M-S-Ali/raven-i-sentinel/electronics/PCB_BQ76925_ATMEGA328P_6S_20A_BMS/pcb_assets/BQ76925_ATMEGA328P_6S_20A_BMS.jpg

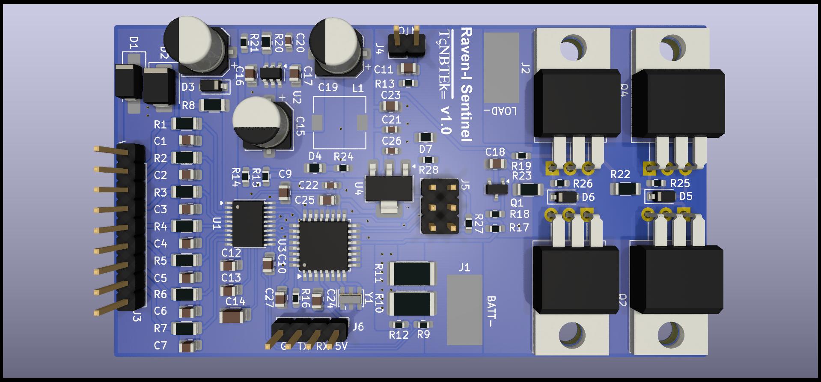
electronics/PCB_BQ76925_ATMEGA328P_6S_20A_BMS/pcb_assets/BQ76925_ATMEGA328P_6S_20A_BMS.jpg
