M-S-Ali/raven-i-sentinel/README.md

# Raven I Sentinel

  
