M-S-Ali/raven-i-sentinel/docs/datasheets.md

# Datasheets

This document provides links to official datasheets and manuals for the major components used in this project.

---

## Microcontroller
- **ATmega328P**  
  [ATmega328 Datasheet (Microchip)](https://www.microchip.com/en-us/product/atmega328p)
---

## Analog Front End IC
- **BQ76925 AFE**  
  [BQ76925 Datasheet (Texas Instruments)](https://www.ti.com/lit/ds/symlink/bq76925.pdf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)    
  [BQ76925 Getting Started Application Report](https://www.ti.com/lit/an/slua619b/slua619b.pdf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)
---

## Voltage Regulators
- **LMR50410**   
  [LMR50410 Simple Switcher Datasheet(Texas Instruments)](https://www.ti.com/lit/ds/symlink/lmr50410.pdf)   

- **AMS1117-5.0**   
  [AMS1117-5.0 Low Dropout Regulator Datasheet (Advanced Monolithic Systems)](http://www.advanced-monolithic.com/pdf/ds1117.pdf)
---

## MOSFET
- **IRFB4110**
  [IRFB4110 Power MOSFET Datasheet (Infineon)](https://www.infineon.com/dgdl/irfb4110pbf.pdf?fileId=5546d462533600a401535615a9571e0b)
---

## Shunt Resistor   
- **WSTM2512DLR002FYR (2mOhm Resistor)**    
  [2mOhm Chip Resistor Datasheet (Littlefuse)](https://mm.digikey.com/Volume0/opasdata/d220001/medias/docus/4897/WSTM_Series_3-17-23.pdf)
---

## Transistor    
- **BC817**    
  [BC817 NPN Datasheet (Diodes Incorporated)](https://www.diodes.com/assets/Datasheets/ds11107.pdf)
---
