M-S-Ali/raven-i-sentinel/electronics/PCB_BQ76925_ATMEGA328P_6S_20A_BMS/pcb_library/3d_models/C_0603_1608Metric.step

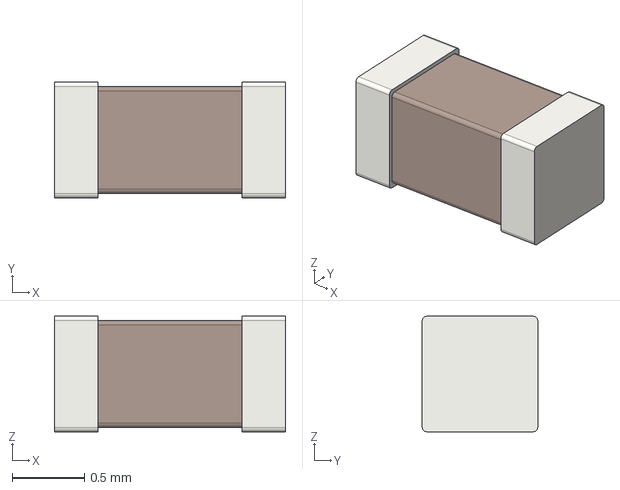
[picture p3: CAD file, 2024-12-04]
electronics/PCB_BQ76925_ATMEGA328P_6S_20A_BMS/pcb_library/3d_models/C_0603_1608Metric.step
1.60 x 0.8 x 0.8 mm
