M-S-Ali/raven-i-sentinel/electronics/PCB_BQ76925_ATMEGA328P_6S_20A_BMS/pcb_library/3d_models/Resonator_SMD_Murata_CSTxExxV-3Pin_3.0x1.1mm.step

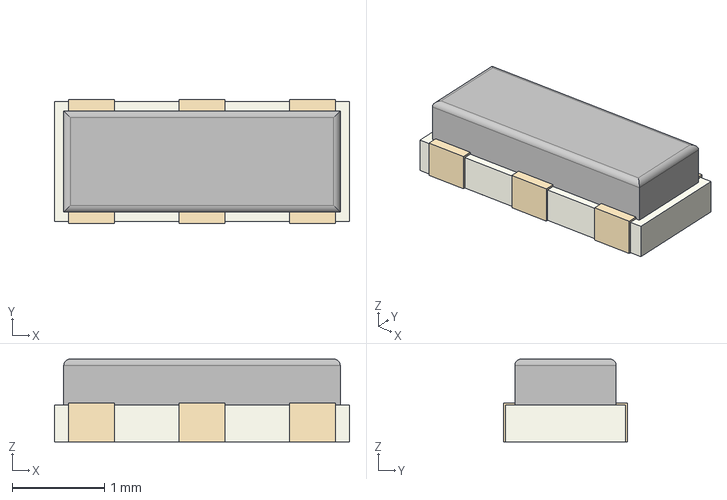
[picture p4: CAD file, 2024-12-04]
electronics/PCB_BQ76925_ATMEGA328P_6S_20A_BMS/pcb_library/3d_models/Resonator_SMD_Murata_CSTxExxV-3Pin_3.0x1.1mm.step
3.20 x 1.35 x 0.9 mm
