M-S-Ali/raven-i-sentinel/electronics/PCB_BQ76925_ATMEGA328P_6S_20A_BMS/pcb_library/3d_models/D_SOD-123.step

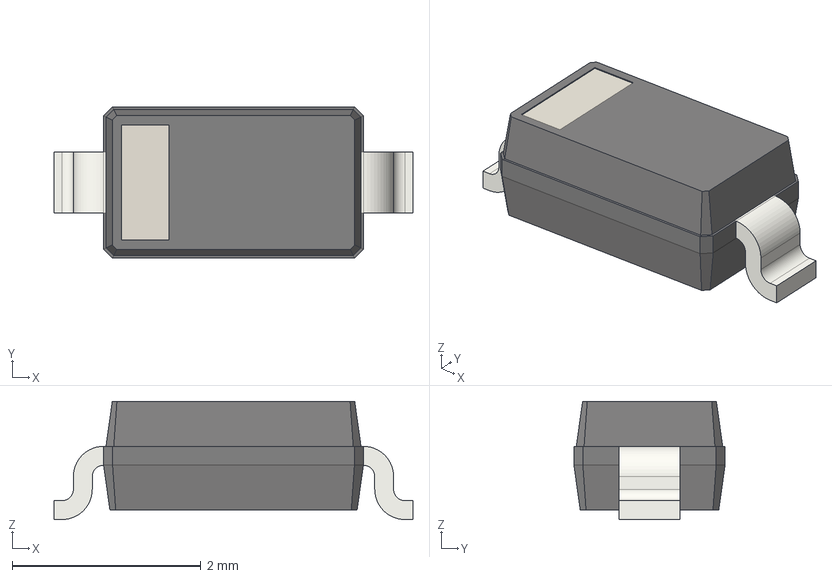
[picture p5: CAD file, 2024-12-04]
electronics/PCB_BQ76925_ATMEGA328P_6S_20A_BMS/pcb_library/3d_models/D_SOD-123.step
3.80 x 1.60 x 1.25 mm
