M-S-Ali/raven-i-sentinel/electronics/PCB_BQ76925_ATMEGA328P_6S_20A_BMS/pcb_library/3d_models/D_SMB.step

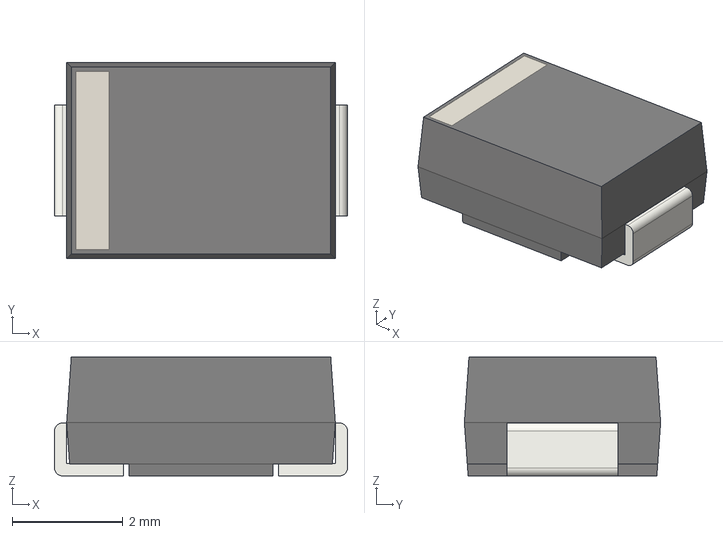
[picture p6: CAD file, 2024-12-04]
electronics/PCB_BQ76925_ATMEGA328P_6S_20A_BMS/pcb_library/3d_models/D_SMB.step
5.30 x 3.55 x 2.15 mm
