M-S-Ali/raven-i-sentinel/electronics/PCB_BQ76925_ATMEGA328P_6S_20A_BMS/pcb_library/3d_models/TSSOP-20_4.4x6.5mm_P0.65mm.step

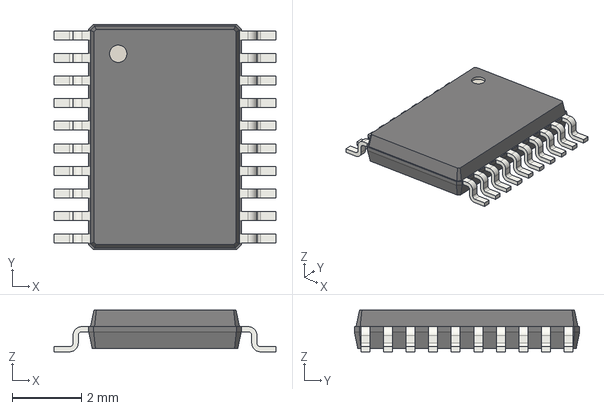
[picture p15: CAD file, 2024-12-04]
electronics/PCB_BQ76925_ATMEGA328P_6S_20A_BMS/pcb_library/3d_models/TSSOP-20_4.4x6.5mm_P0.65mm.step
6.40 x 6.50 x 1.20 mm
