M-S-Ali/raven-i-sentinel/electronics/PCB_BQ76925_ATMEGA328P_6S_20A_BMS/pcb_library/3d_models/TQFP-32_7x7mm_P0.8mm.step

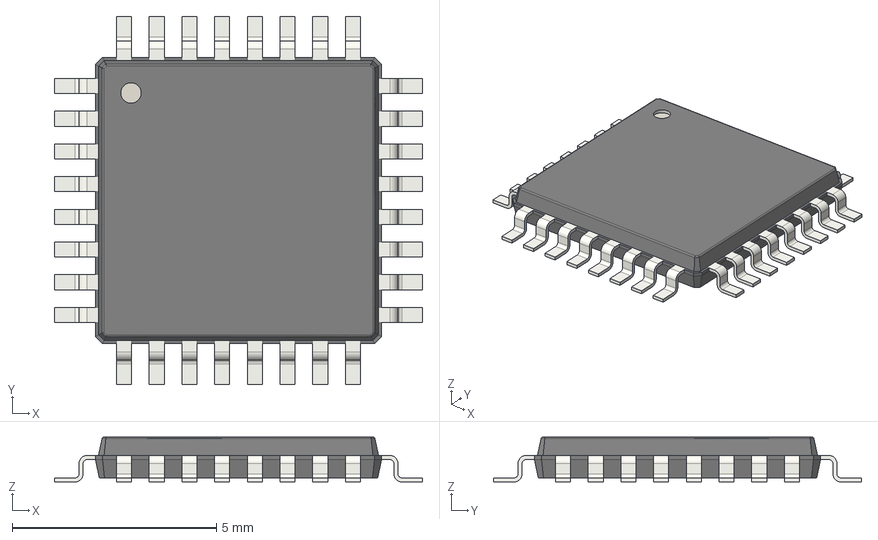
[picture p19: CAD file, 2024-12-04]
electronics/PCB_BQ76925_ATMEGA328P_6S_20A_BMS/pcb_library/3d_models/TQFP-32_7x7mm_P0.8mm.step
9.00 x 9.00 x 1.10 mm
