M-S-Ali/raven-i-sentinel/electronics/PCB_BQ76925_ATMEGA328P_6S_20A_BMS/pcb_library/3d_models/CP_Elec_6.3x5.7.step

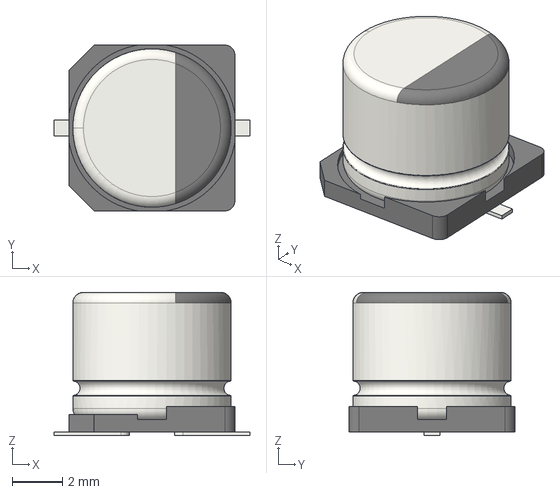
[picture p20: CAD file, 2024-12-04]
electronics/PCB_BQ76925_ATMEGA328P_6S_20A_BMS/pcb_library/3d_models/CP_Elec_6.3x5.7.step
7.80 x 6.60 x 5.70 mm
