M-S-Ali/raven-i-sentinel/electronics/PCB_BQ76925_ATMEGA328P_6S_20A_BMS/pcb_library/3d_models/TO-220-3_Horizontal_TabDown.step

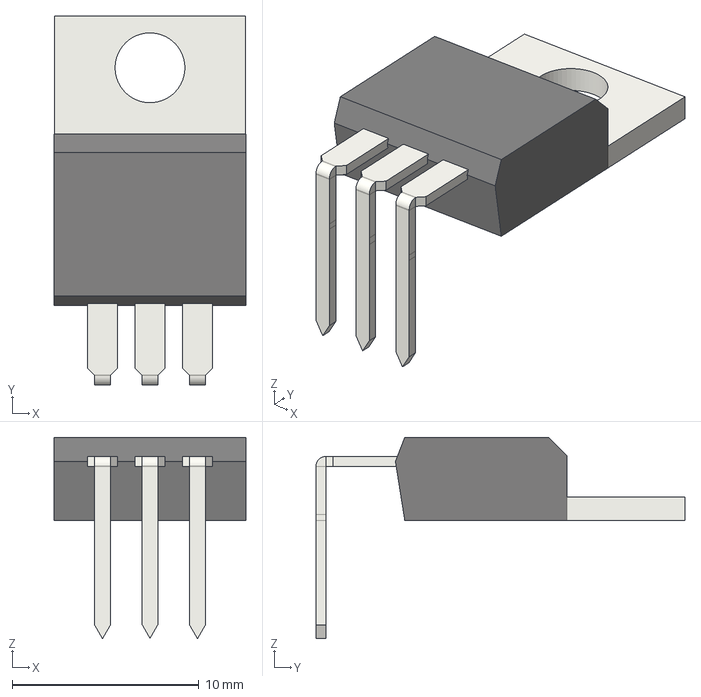
[picture p22: CAD file, 2024-12-04]
electronics/PCB_BQ76925_ATMEGA328P_6S_20A_BMS/pcb_library/3d_models/TO-220-3_Horizontal_TabDown.step
10.2 x 19.7 x 10.8 mm
