M-S-Ali/raven-i-sentinel/electronics/PCB_BQ76925_ATMEGA328P_6S_20A_BMS/pcb_library/3d_models/PinHeader_2x03_P2.54mm_Vertical.step

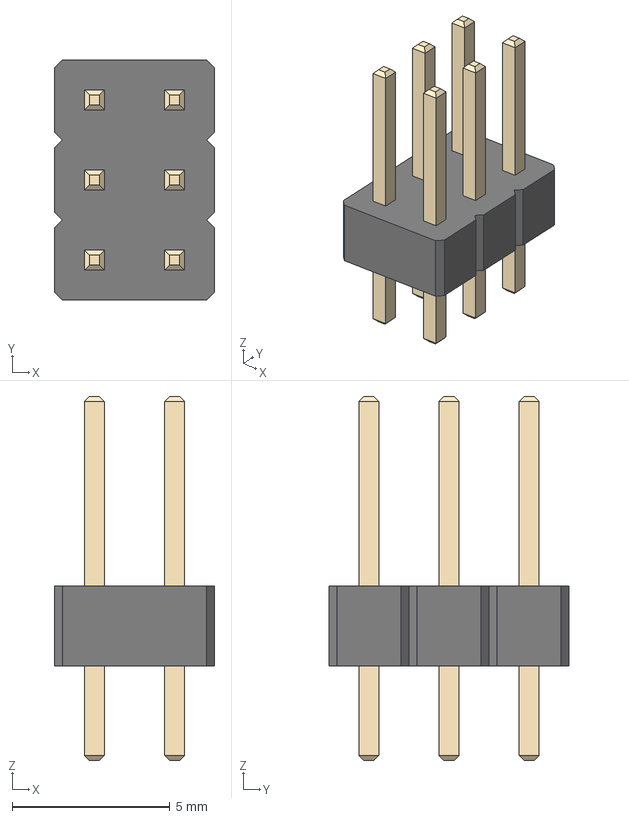
[picture p23: CAD file, 2024-12-04]
electronics/PCB_BQ76925_ATMEGA328P_6S_20A_BMS/pcb_library/3d_models/PinHeader_2x03_P2.54mm_Vertical.step
5.08 x 7.62 x 11.5 mm
