M-S-Ali/raven-i-sentinel/electronics/PCB_BQ76925_ATMEGA328P_6S_20A_BMS/pcb_assets/BQ76925_ATMEGA328P_6S_20A_BMS.pdf

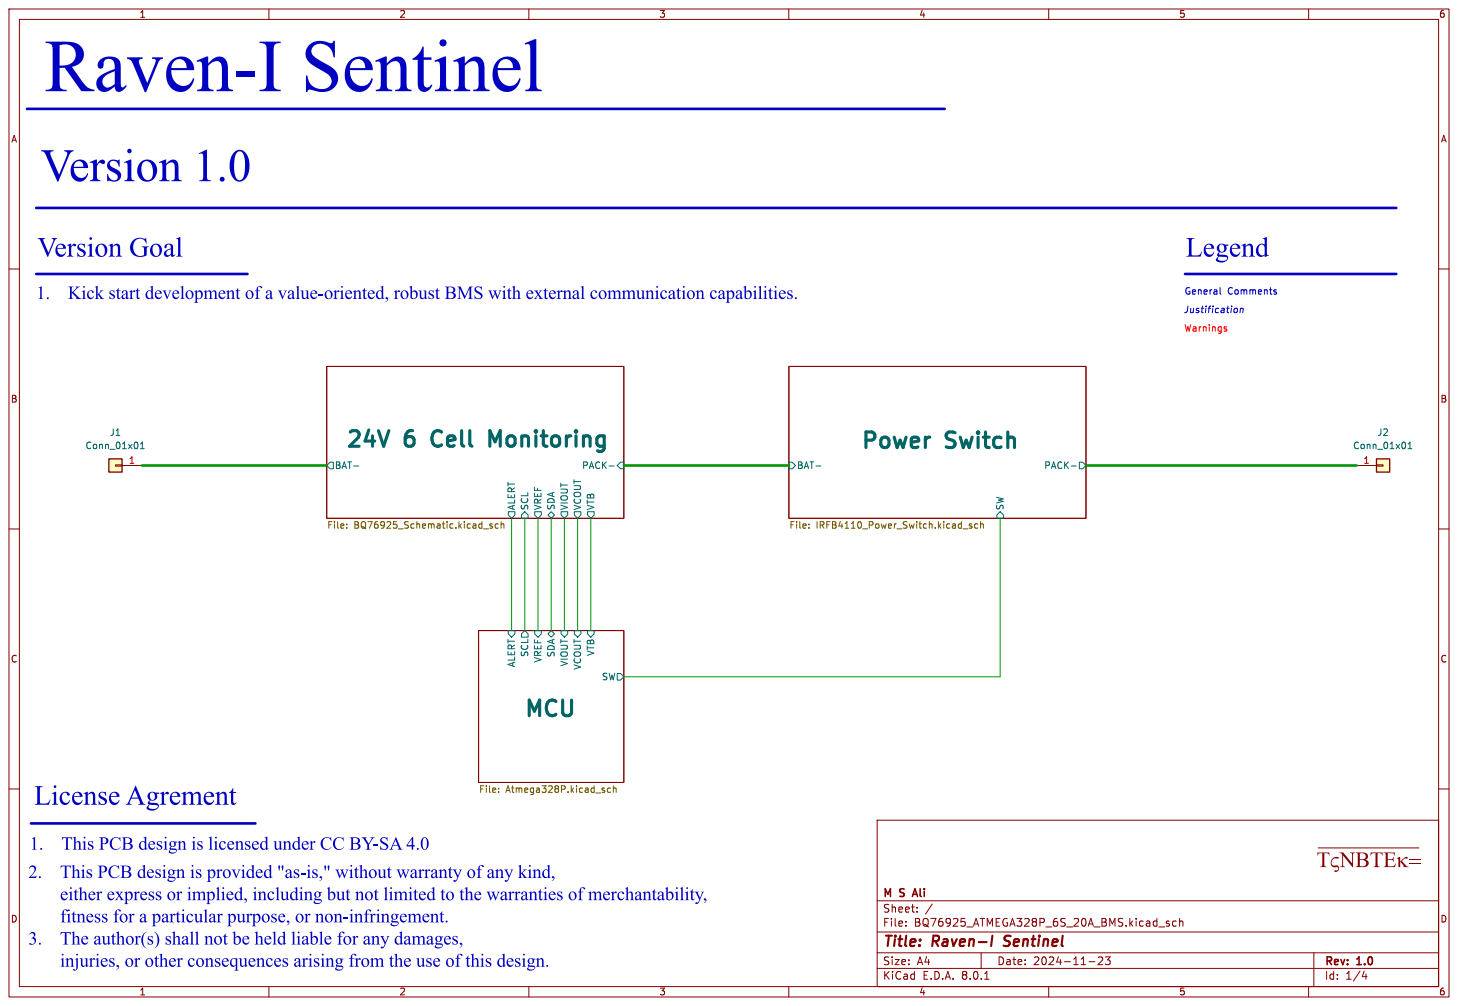
[picture p25: page 1]

J2 Conn_01x01 1. Kick startdevelopmentof a value-oriented,robustBMS with externalcommunicationcapabilities.
Warnings General Comments 1. This PCBdesignis licensedunderCC BY-SA4.0

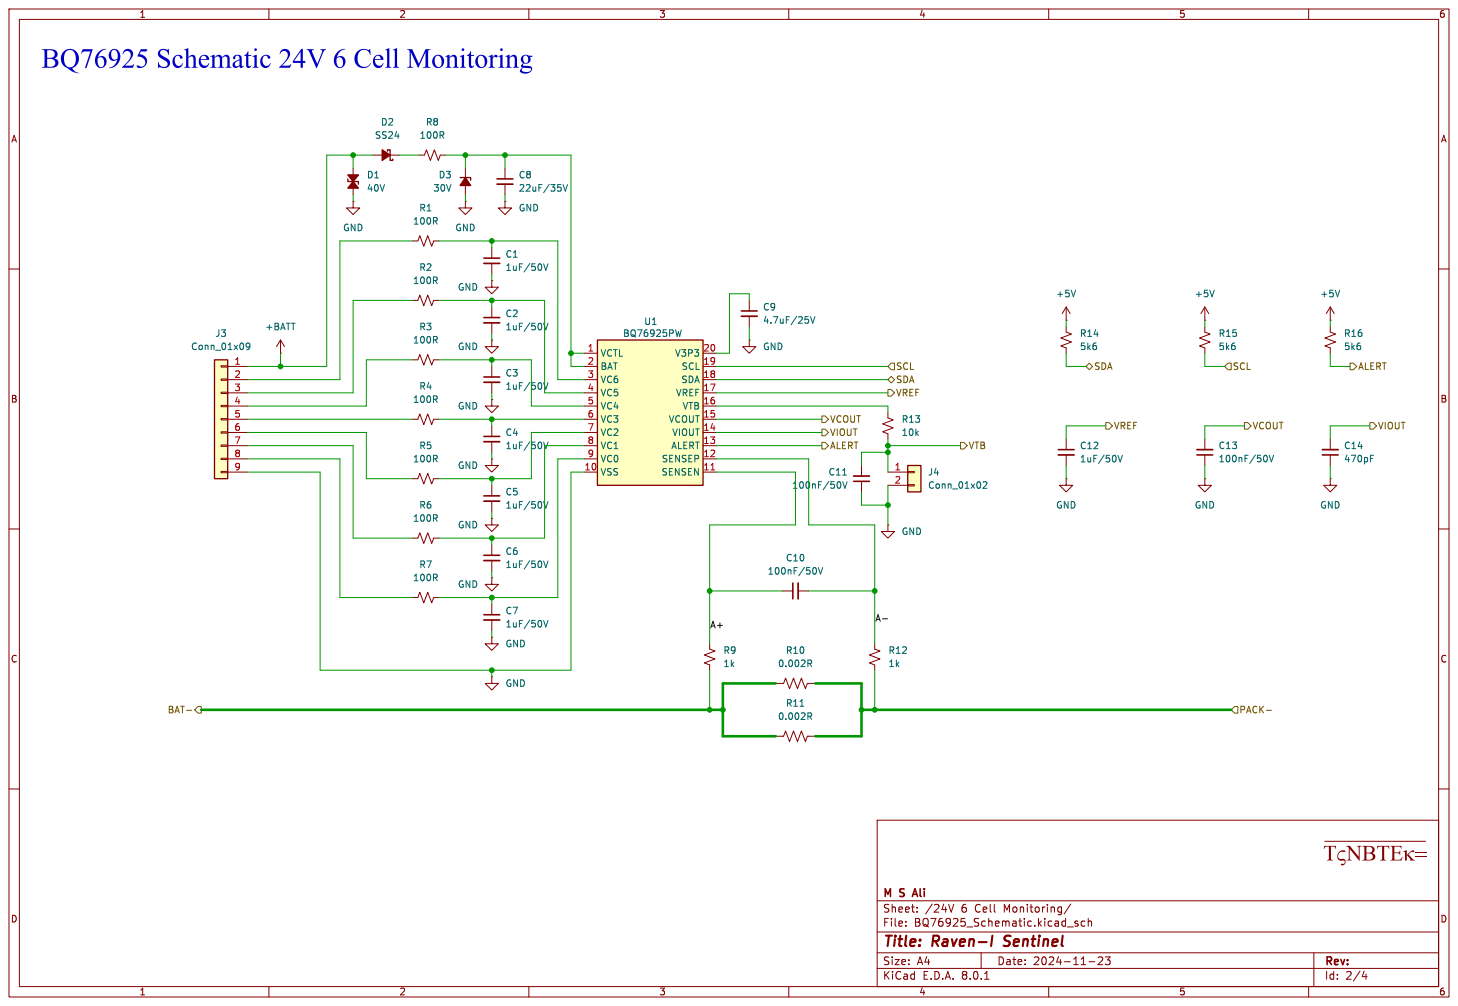
[picture p26: page 2]

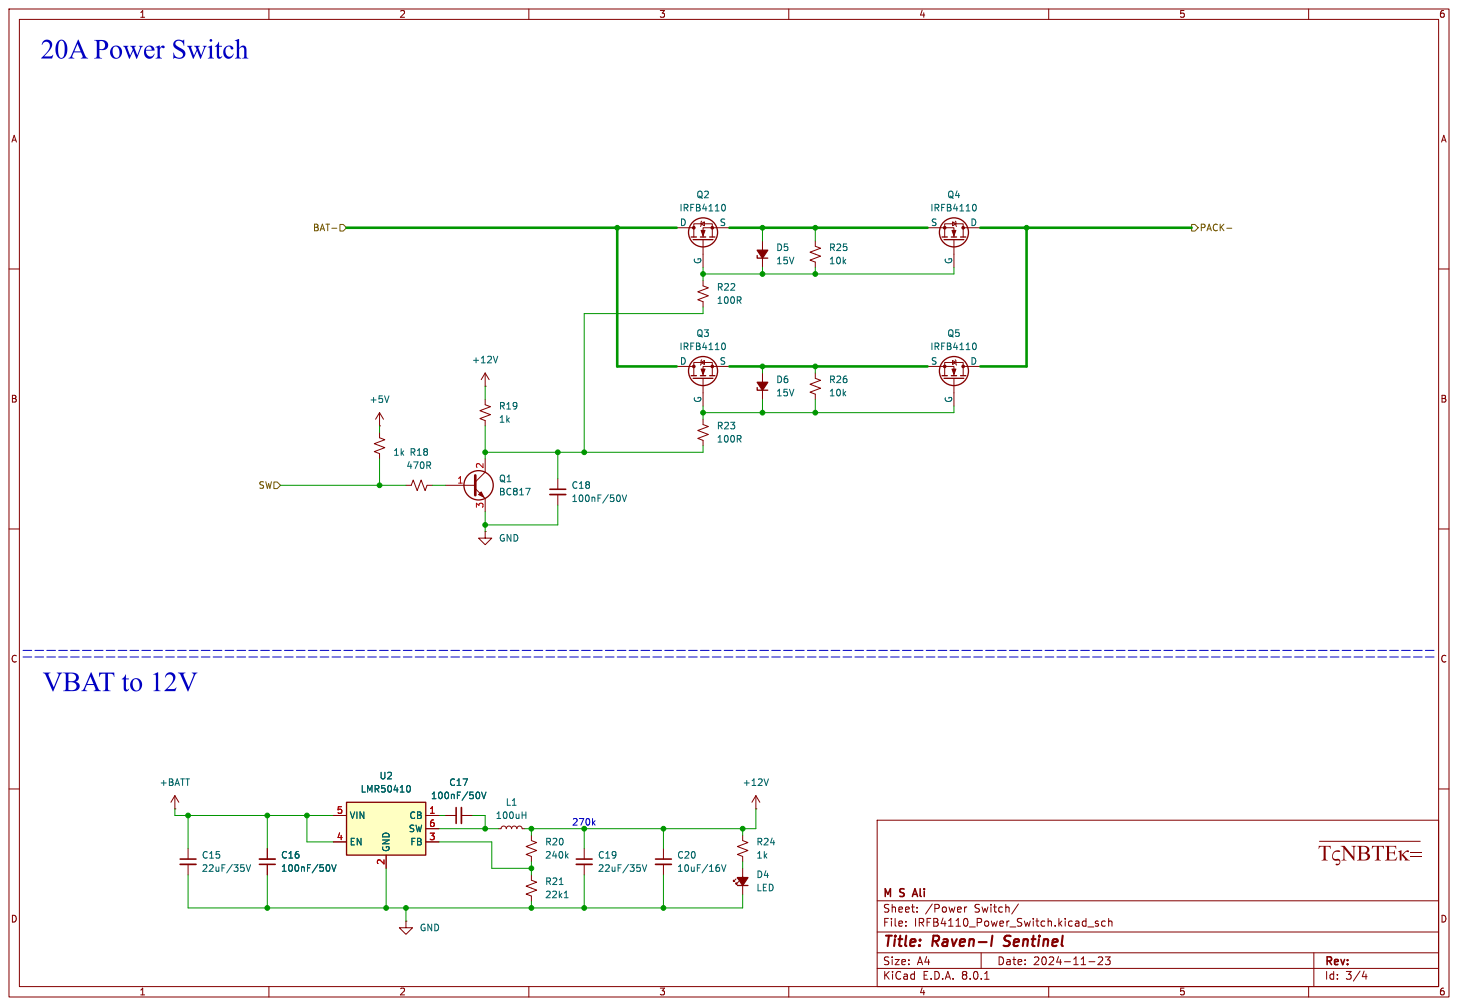
[picture p27: page 3]

2 FB 3 EN 4 VIN 5 SW 6 U2

2 FB 3 EN 4 VIN 5 SW 6 C16

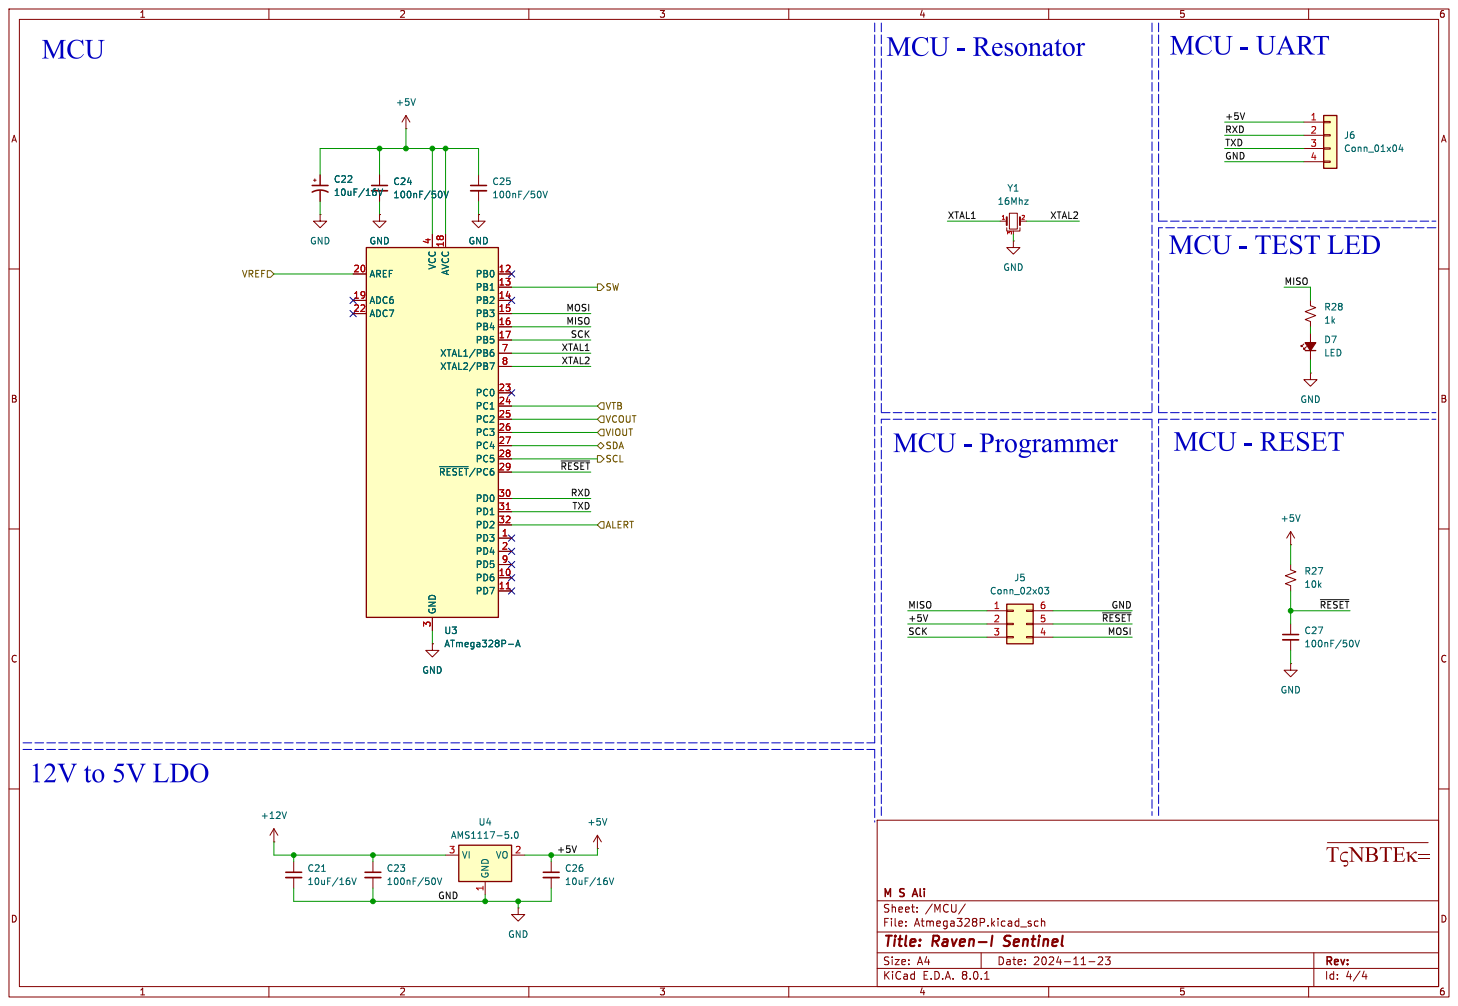
[picture p28: page 4]

~{RESET} +5V MISO MOSI MISO
