M-S-Ali/raven-i-sentinel/electronics/PCB_BQ76925_ATMEGA328P_6S_20A_BMS/BQ76925_ATMEGA328P_6S_20A_BMS.kicad_pcb

## KiCad design electronics/PCB_BQ76925_ATMEGA328P_6S_20A_BMS/BQ76925_ATMEGA328P_6S_20A_BMS.kicad_pcb (2024-12-04)

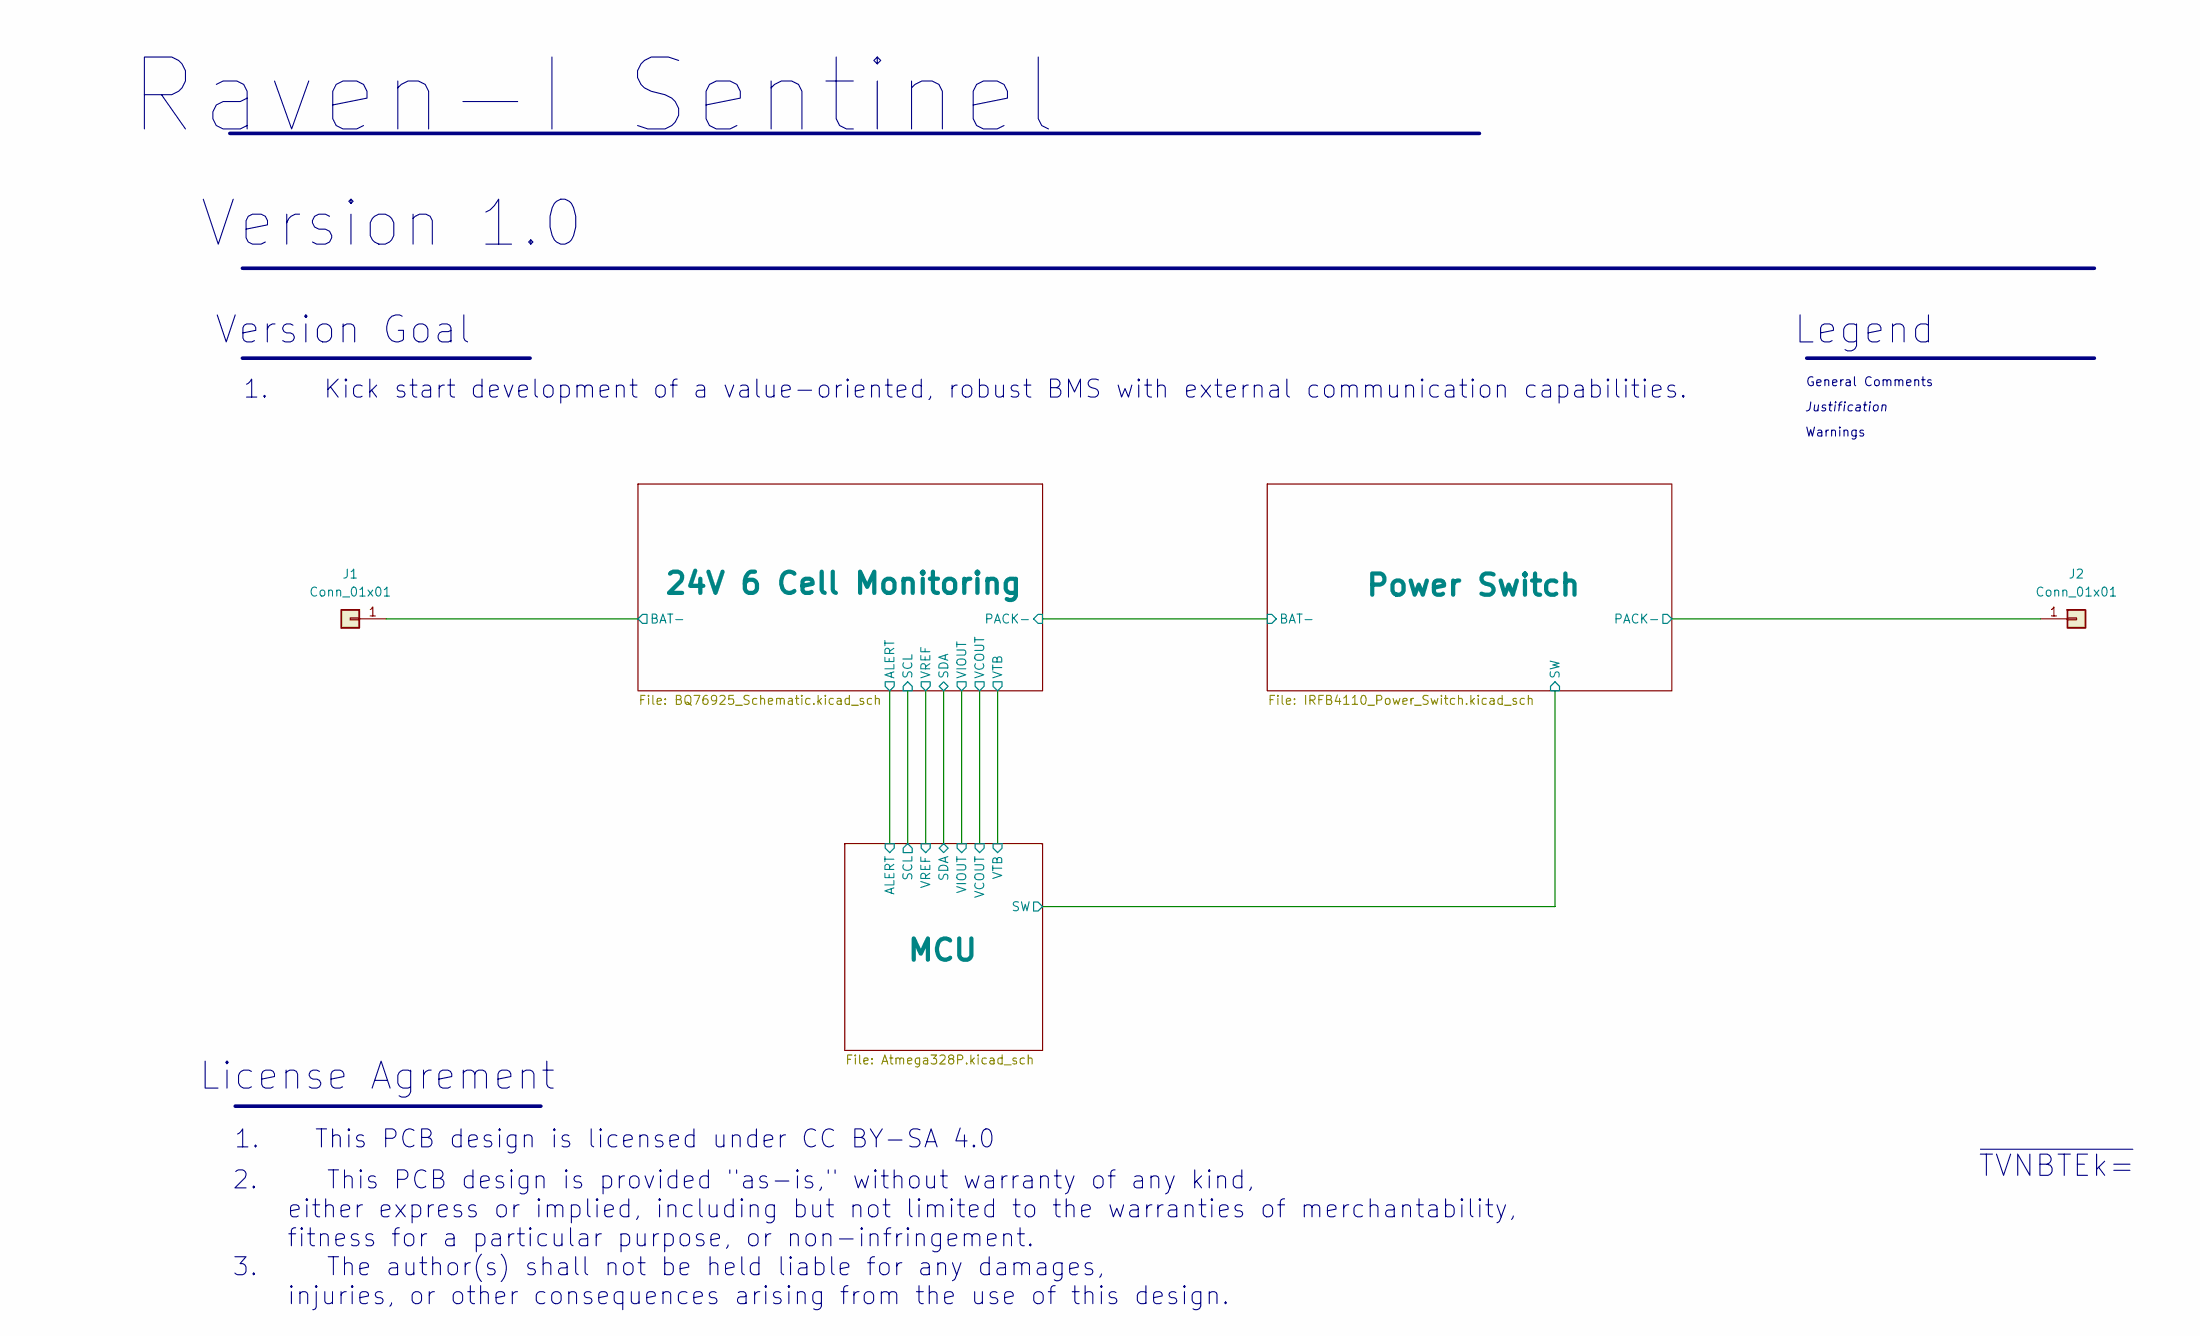
[picture p29: schematic BQ76925_ATMEGA328P_6S_20A_BMS.kicad_sch, Raven-I Sentinel]

Parts:
J1, J2: Conn_01x01; SolderWirePad_1x01_SMD_5x10mm

Connections:
/24V 6 Cell Monitoring/BAT-: J1.1; also elsewhere on the board
/Power Switch/PACK-: J2.1; also elsewhere on the board

Notes on the sheet:
1. This PCB design is licensed under CC BY-SA 4.0
Justification
1. Kick start development of a value-oriented, robust BMS with external communication capabilities.
~{TVNBTEk=}
License Agrement
Warnings
2. This PCB design is provided "as-is," without warranty of any kind, either express or implied, including but not limited to the warranties of merchantability, fitness for a particular purpose, or non-infringement. 3. The author(s) shall not be held liable for any damages, injuries, or other conse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
General Comments
Version ${REVISION}
Raven-I Sentinel
Version Goal
Legend

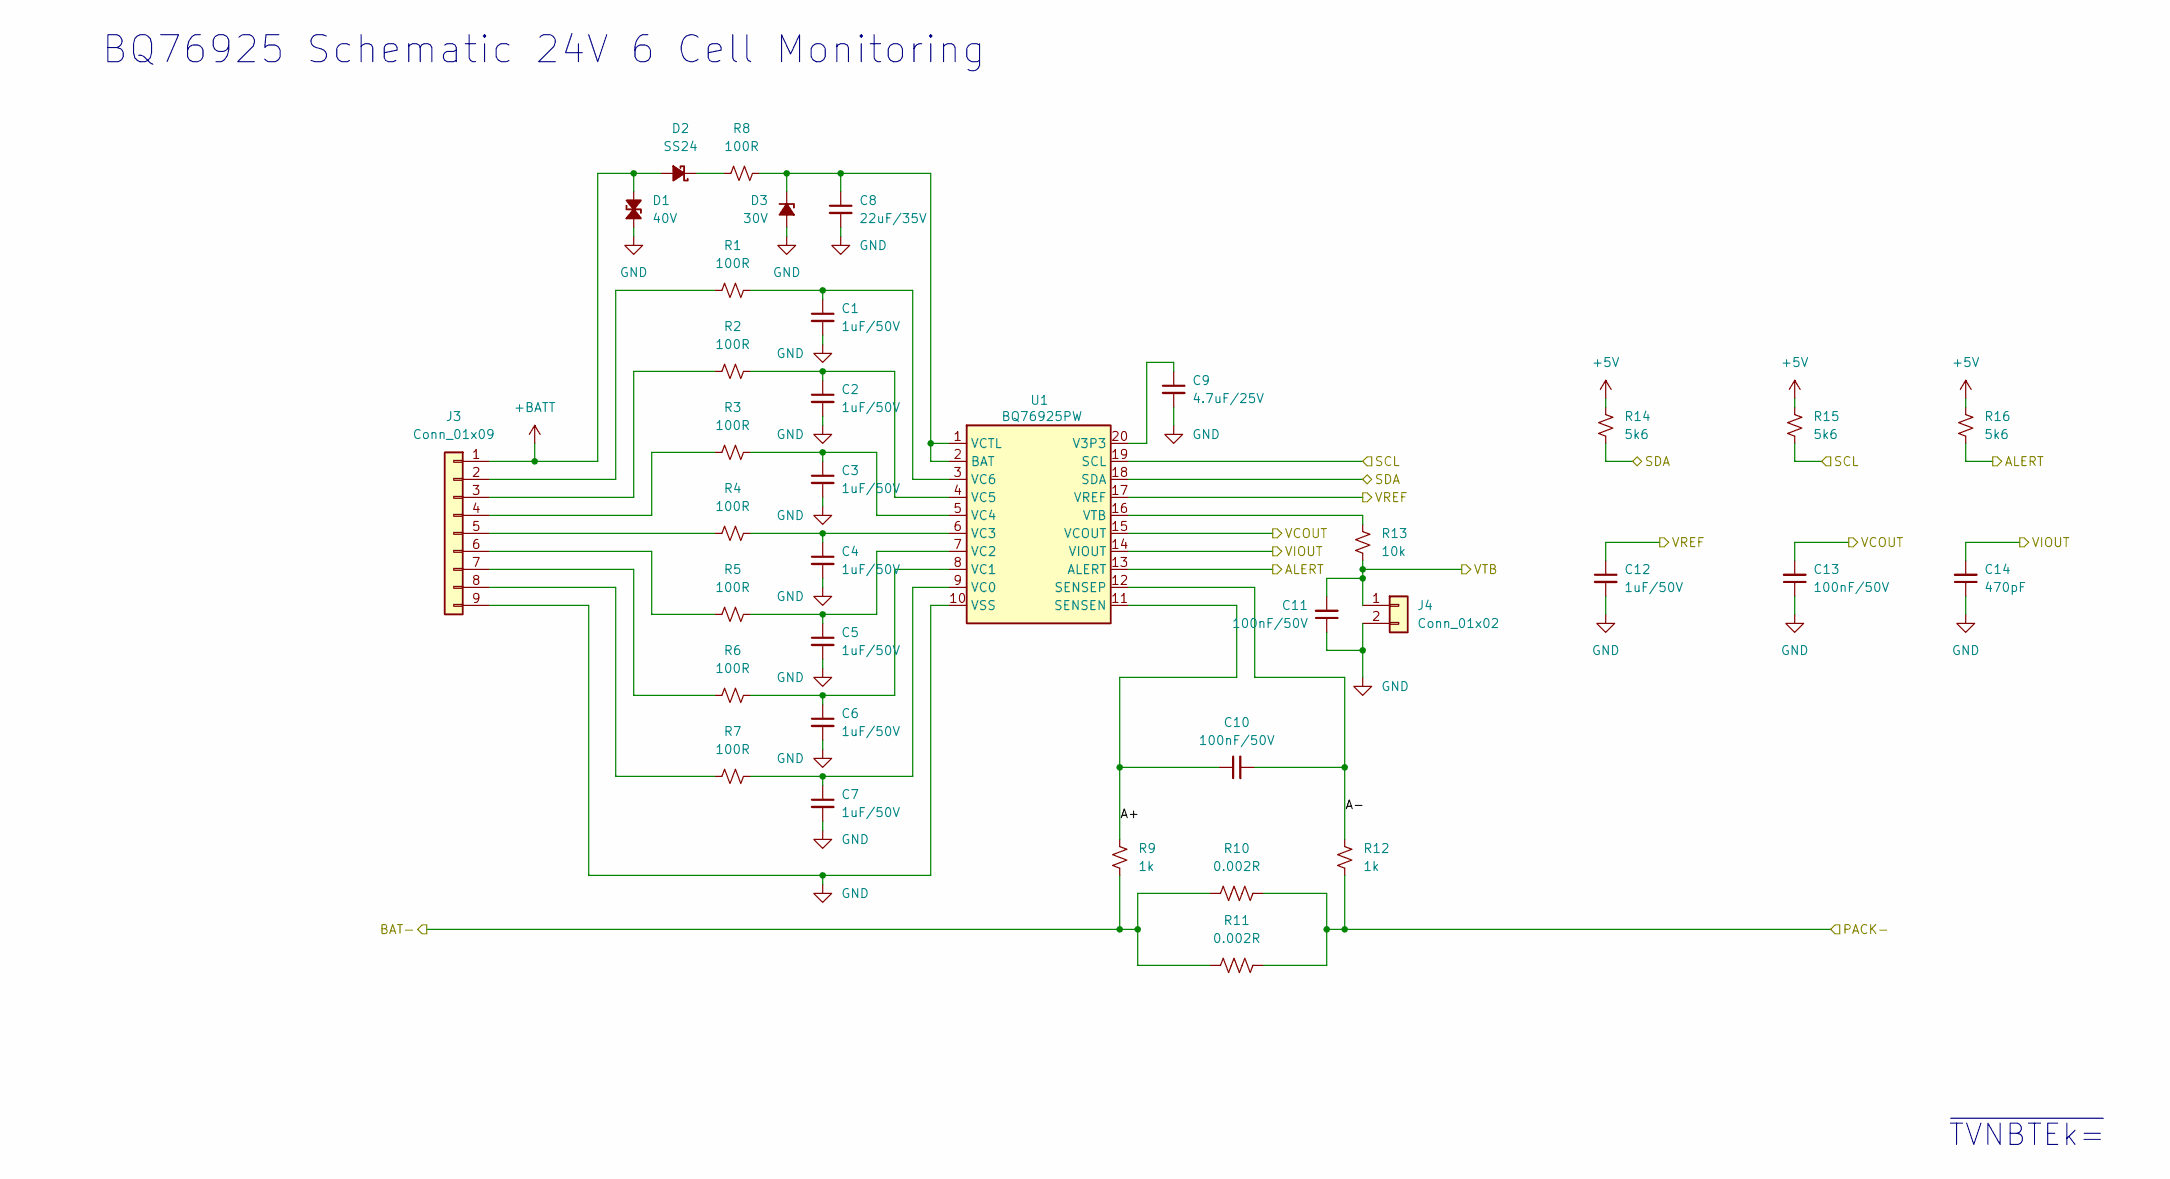
[picture p30: schematic BQ76925_Schematic.kicad_sch, Raven-I Sentinel]

Parts:
C1, C2, C3, C4, C5, C6, C7, C12: 1uF/50V; C_0805_2012Metric_Pad1.18x1.45mm_HandSolder
C8: 22uF/35V; CP_Elec_6.3x5.7
C9: 4.7uF/25V; C_0805_2012Metric_Pad1.18x1.45mm_HandSolder
C10, C11, C13: 100nF/50V; C_0805_2012Metric_Pad1.18x1.45mm_HandSolder
C14: 470pF; C_1206_3216Metric_Pad1.33x1.80mm_HandSolder
D1: 40V; D_SMA_Handsoldering
D2: SS24; D_SMB
D3: 30V; D_SOD-123
J3: Conn_01x09; PinHeader_1x09_P2.54mm_Vertical
J4: Conn_01x02; PinHeader_1x02_P2.54mm_Vertical
R1, R2, R3, R4, R5, R6, R7, R8: 100R; R_1206_3216Metric_Pad1.30x1.75mm_HandSolder
R9, R12: 1k; R_0603_1608Metric_Pad0.98x0.95mm_HandSolder
R10, R11: 0.002R; R_2512_6332Metric
R13: 10k; R_0603_1608Metric_Pad0.98x0.95mm_HandSolder
R14, R15, R16: 5k6; R_0603_1608Metric_Pad0.98x0.95mm_HandSolder
U1: BQ76925PW; TSSOP-20_4.4x6.5mm_P0.65mm

Connections:
+5V: R14.2, R15.2, R16.2; also elsewhere on the board
+BATT: D1.2 (A2), D2.2 (A), J3.1; also elsewhere on the board
/24V 6 Cell Monitoring/A+: C10.1, R9.2, U1.11 (SENSEN)
/24V 6 Cell Monitoring/A-: C10.2, R12.2, U1.12 (SENSEP)
/24V 6 Cell Monitoring/ALERT: R16.1, U1.13 (ALERT); also elsewhere on the board
/24V 6 Cell Monitoring/BAT-: R9.1, R10.1, R11.1; also elsewhere on the board
/24V 6 Cell Monitoring/PACK-: R10.2, R11.2, R12.1; also elsewhere on the board
/24V 6 Cell Monitoring/SCL: R15.1, U1.19 (SCL); also elsewhere on the board
/24V 6 Cell Monitoring/SDA: R14.1, U1.18 (SDA); also elsewhere on the board
/24V 6 Cell Monitoring/VCOUT: C13.2, U1.15 (VCOUT); also elsewhere on the board
/24V 6 Cell Monitoring/VIOUT: C14.2, U1.14 (VIOUT); also elsewhere on the board
/24V 6 Cell Monitoring/VREF: C12.1, U1.17 (VREF); also elsewhere on the board
/24V 6 Cell Monitoring/VTB: C11.2, J4.1, R13.1; also elsewhere on the board
GND: C1.2, C2.2, C3.2, C4.2, C5.2, C6.2, C7.2, C8.2, C9.2, C11.1, C12.2, C13.1, C14.1, D1.1 (A1), D3.2 (A), J3.9, J4.2, U1.10 (VSS); also elsewhere on the board
unnamed: D2.1 (K), R8.1
unnamed: C8.1, D3.1 (K), R8.2, U1.1 (VCTL), U1.2 (BAT)
unnamed: J3.2, R1.1
unnamed: J3.3, R2.1
unnamed: J3.4, R3.1
unnamed: J3.5, R4.1
unnamed: J3.6, R5.1
unnamed: J3.7, R6.1
unnamed: J3.8, R7.1
unnamed: C9.1, U1.20 (V3P3)
unnamed: C7.1, R7.2, U1.9 (VC0)
unnamed: C6.1, R6.2, U1.8 (VC1)
unnamed: C5.1, R5.2, U1.7 (VC2)
unnamed: C4.1, R4.2, U1.6 (VC3)
unnamed: C3.1, R3.2, U1.5 (VC4)
unnamed: C2.1, R2.2, U1.4 (VC5)
unnamed: C1.1, R1.2, U1.3 (VC6)
unnamed: R13.2, U1.16 (VTB)

Notes on the sheet:
~{TVNBTEk=}
BQ76925 Schematic 24V 6 Cell Monitoring

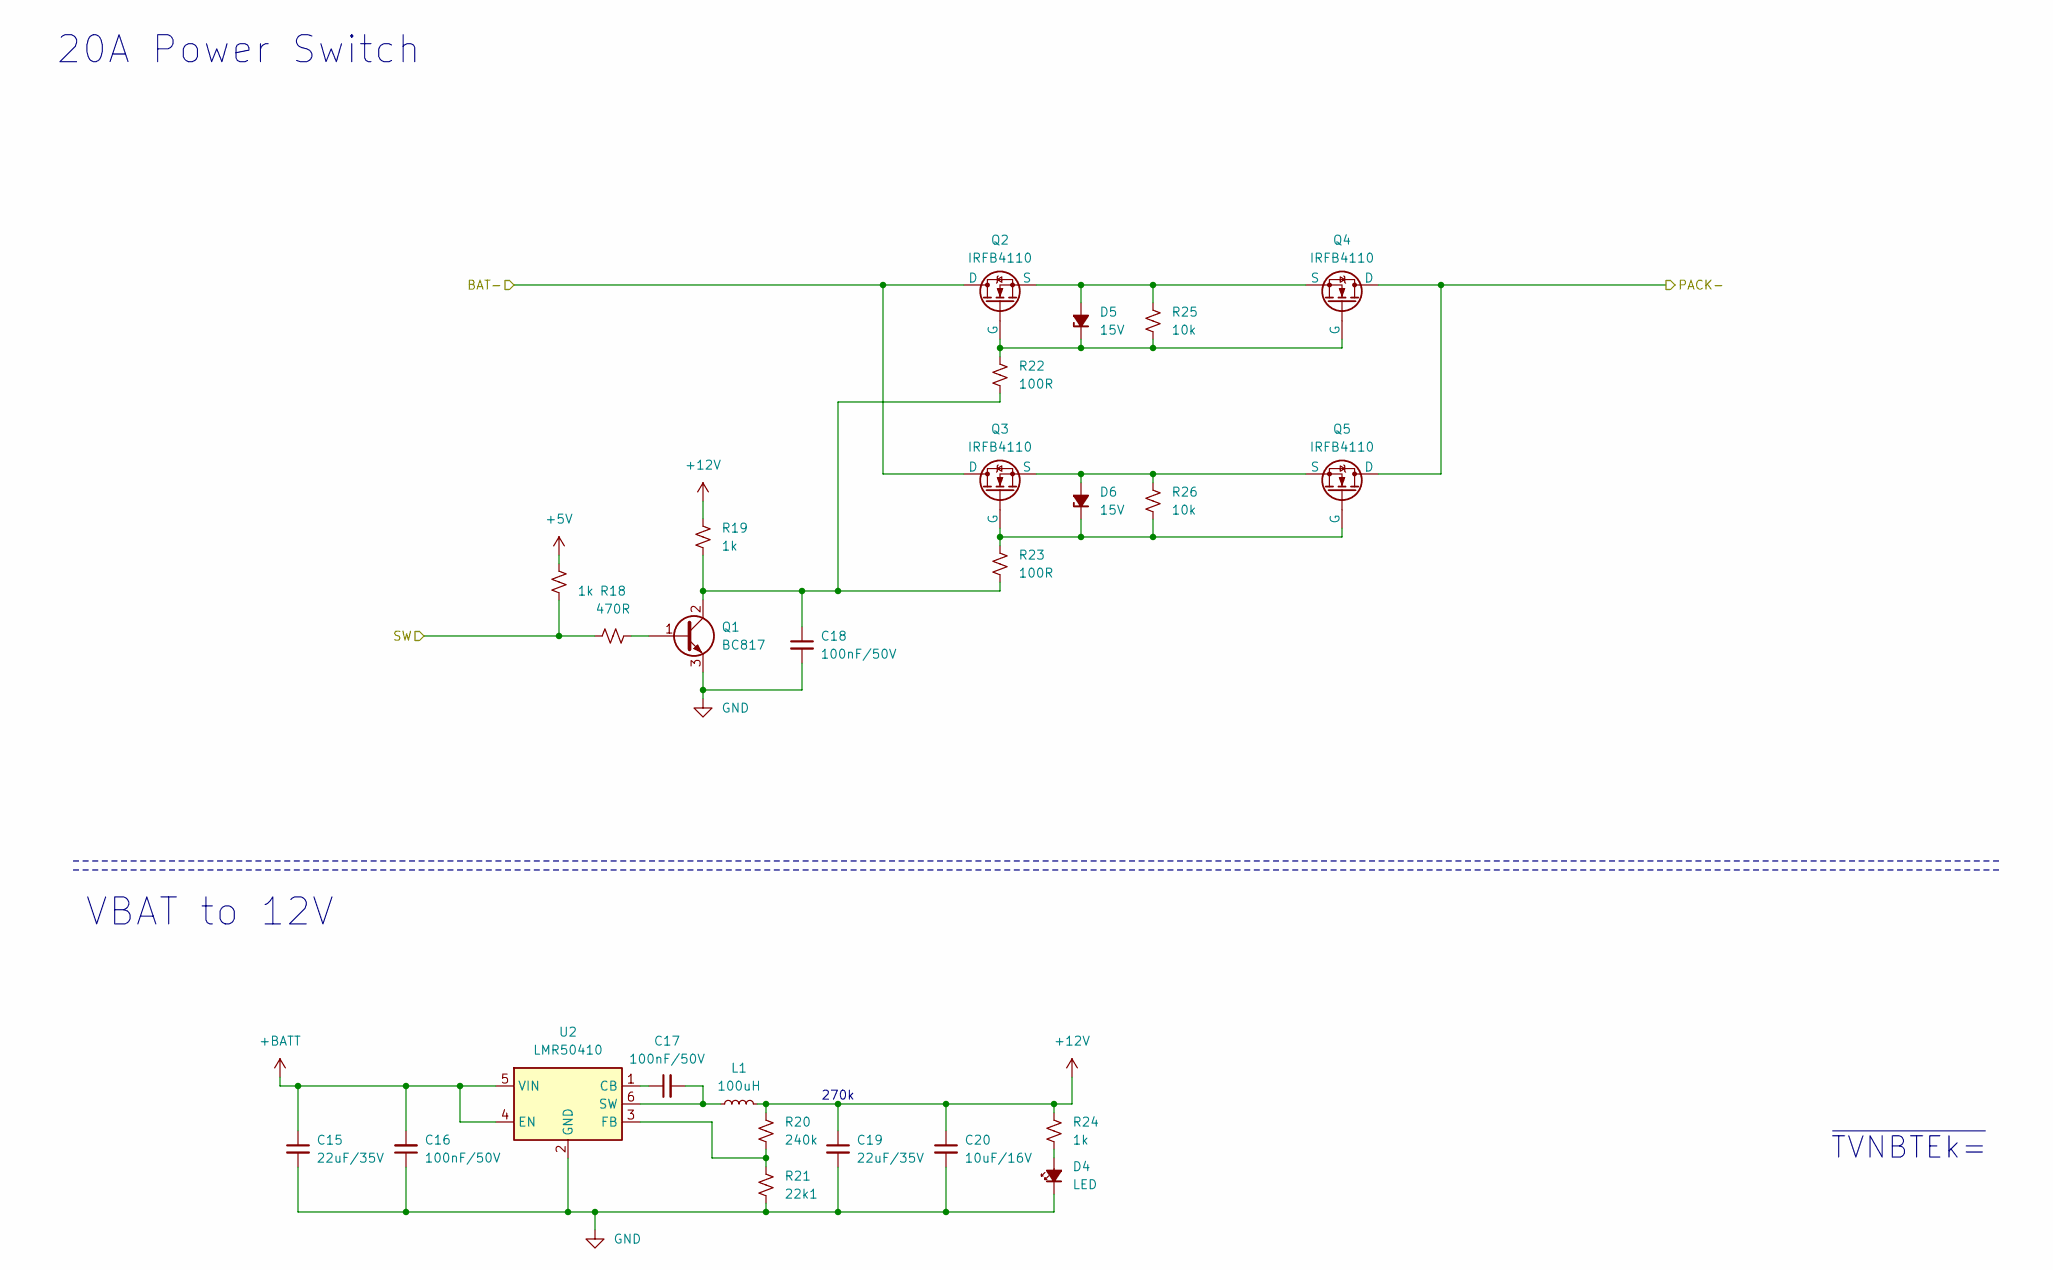
[picture p31: schematic IRFB4110_Power_Switch.kicad_sch, Raven-I Sentinel]

Parts:
C15, C19: 22uF/35V; CP_Elec_6.3x5.7
C16, C17, C18: 100nF/50V; C_0805_2012Metric_Pad1.18x1.45mm_HandSolder
C20: 10uF/16V; C_0603_1608Metric_Pad1.08x0.95mm_HandSolder
D4: LED; R_0805_2012Metric_Pad1.20x1.40mm_HandSolder
D5, D6: 15V; D_SOD-123
L1: 100uH; L_7.3x7.3_H3.5
Q1: BC817; SOT-23
Q2, Q3, Q4, Q5: IRFB4110; TO-220-3_Horizontal_TabDown
R17, R19, R24: 1k; R_0603_1608Metric_Pad0.98x0.95mm_HandSolder
R18: 470R; R_0603_1608Metric_Pad0.98x0.95mm_HandSolder
R20: 240k; R_0805_2012Metric_Pad1.20x1.40mm_HandSolder
R21: 22k1; R_0603_1608Metric_Pad0.98x0.95mm_HandSolder
R22, R23: 100R; R_1206_3216Metric_Pad1.30x1.75mm_HandSolder
R25, R26: 10k; R_0603_1608Metric_Pad0.98x0.95mm_HandSolder
U2: LMR50410; SOT-23-6

Connections:
+5V: R17.2; also elsewhere on the board
+12V: C19.1, C20.1, L1.2, R19.2, R20.1, R24.1; also elsewhere on the board
+BATT: C15.1, C16.2, U2.4 (EN), U2.5 (VIN); also elsewhere on the board
/24V 6 Cell Monitoring/PACK-: Q2.2 (D), Q3.2 (D); also elsewhere on the board
/MCU/SW: R17.1, R18.2; also elsewhere on the board
/Power Switch/PACK-: Q4.2 (D), Q5.2 (D); also elsewhere on the board
GND: C15.2, C16.1, C18.2, C19.2, C20.2, D4.1 (K), Q1.3 (E), R21.2, U2.2 (GND); also elsewhere on the board
unnamed: D4.2 (A), R24.2
unnamed: D5.2 (A), Q2.3 (S), Q4.3 (S), R25.2
unnamed: D5.1 (K), Q2.1 (G), Q4.1 (G), R22.1, R25.1
unnamed: D6.2 (A), Q3.3 (S), Q5.3 (S), R26.2
unnamed: D6.1 (K), Q3.1 (G), Q5.1 (G), R23.1, R26.1
unnamed: Q1.1 (B), R18.1
unnamed: C18.1, Q1.2 (C), R19.1, R22.2, R23.2
unnamed: C17.1, U2.1 (CB)
unnamed: R20.2, R21.1, U2.3 (FB)
unnamed: C17.2, L1.1, U2.6 (SW)

Notes on the sheet:
270k
~{TVNBTEk=}
VBAT to 12V
20A Power Switch

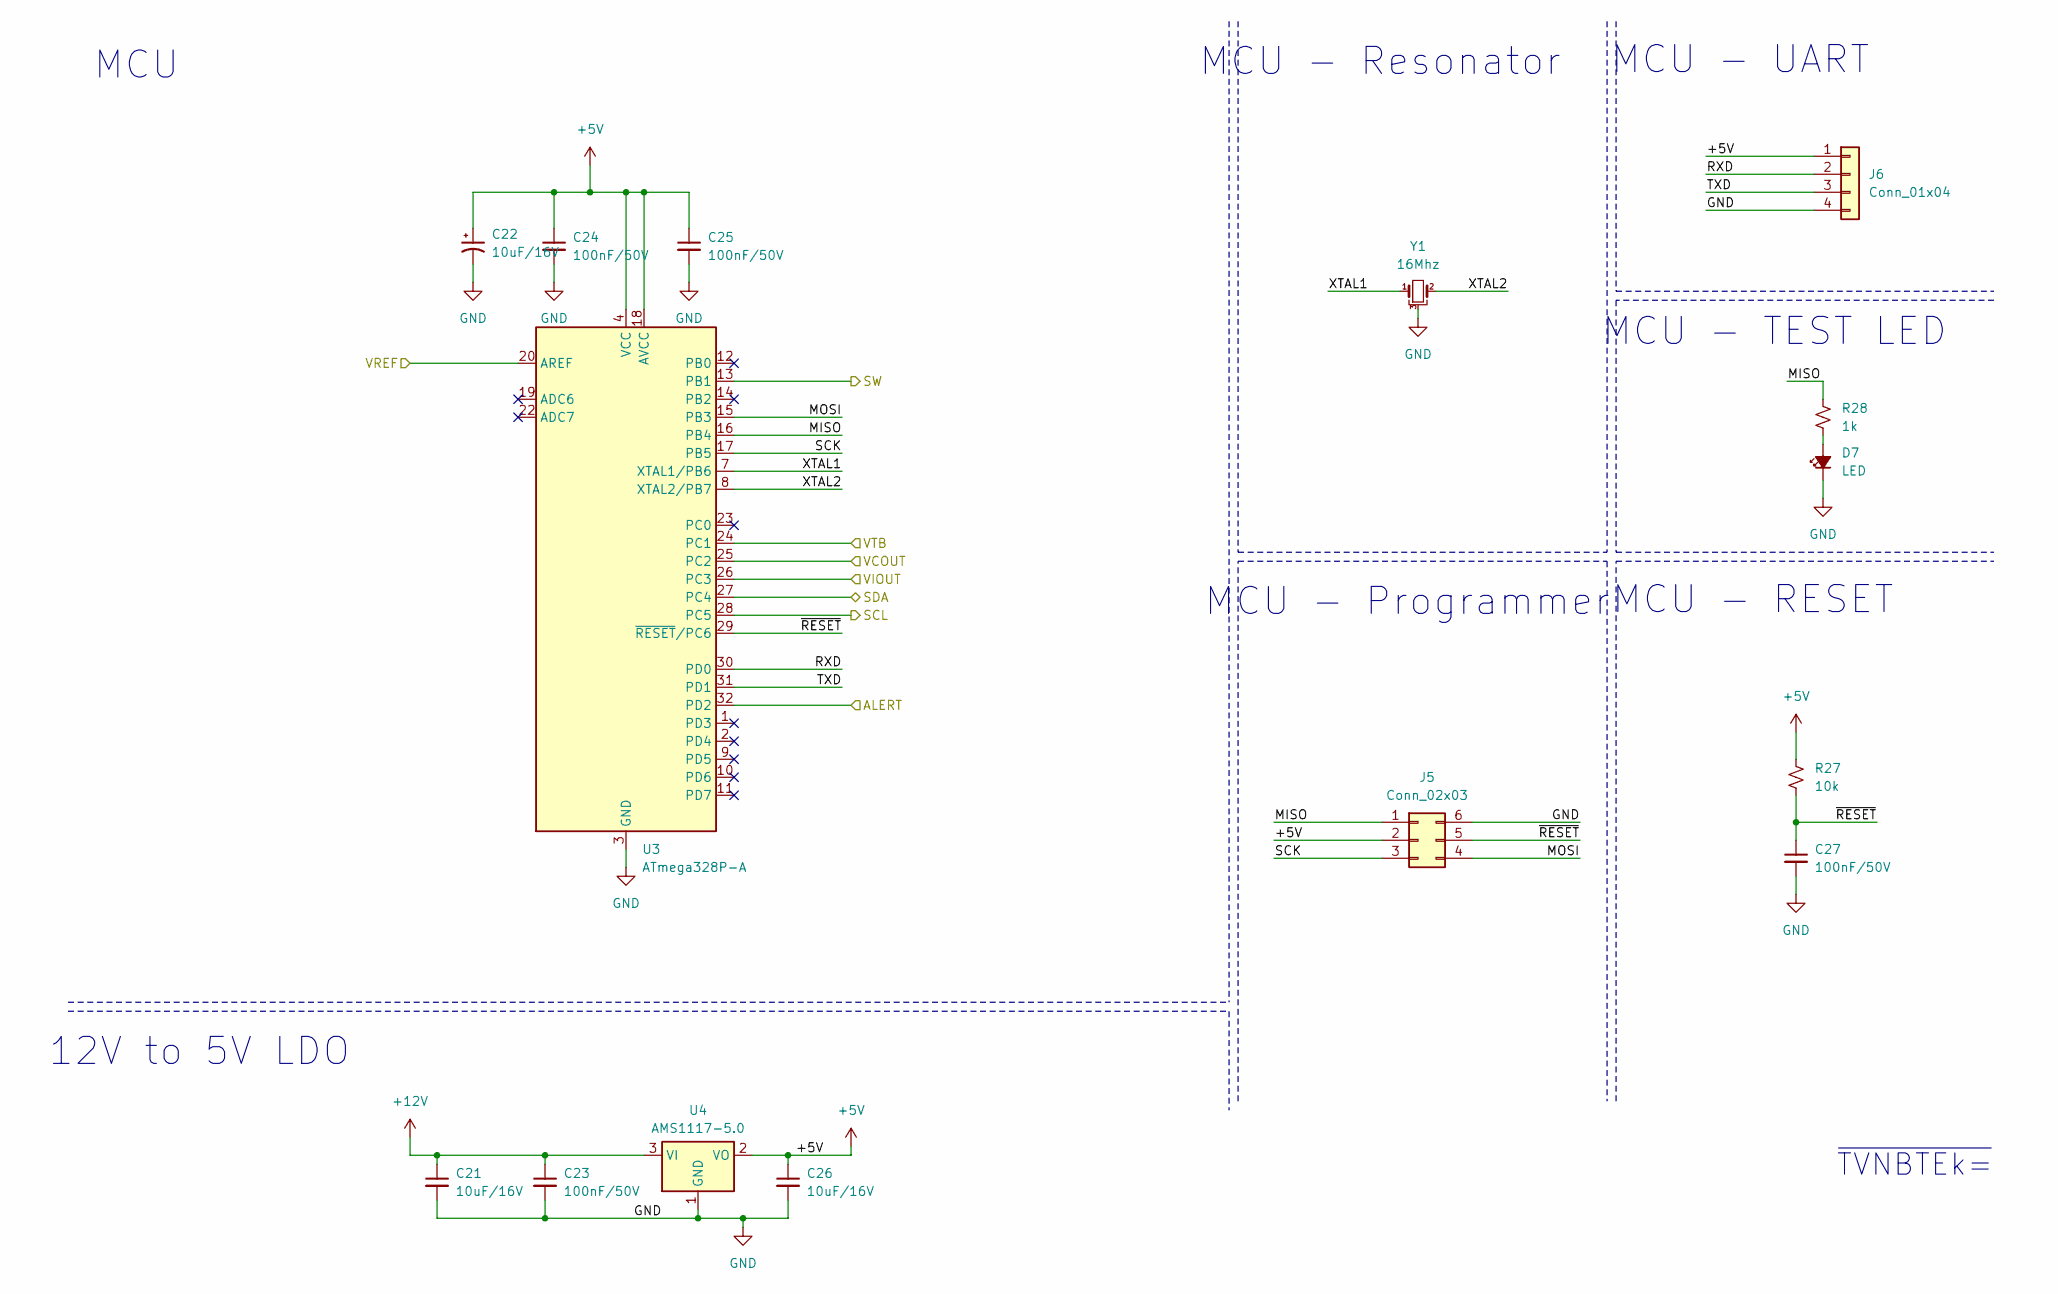
[picture p32: schematic Atmega328P.kicad_sch, Raven-I Sentinel]

Parts:
C21, C22, C26: 10uF/16V; C_0603_1608Metric_Pad1.08x0.95mm_HandSolder
C23, C24, C25, C27: 100nF/50V; C_0805_2012Metric_Pad1.18x1.45mm_HandSolder
D7: LED; R_0805_2012Metric_Pad1.20x1.40mm_HandSolder
J5: Conn_02x03; PinHeader_2x03_P2.54mm_Vertical
J6: Conn_01x04; PinHeader_1x04_P2.54mm_Vertical
R27: 10k; R_0603_1608Metric_Pad0.98x0.95mm_HandSolder
R28: 1k; R_0603_1608Metric_Pad0.98x0.95mm_HandSolder
U3: ATmega328P-A; TQFP-32_7x7mm_P0.8mm
U4: AMS1117-5.0; SOT-223-3_TabPin2
Y1: 16Mhz; Resonator_SMD_Murata_CSTxExxV-3Pin_3.0x1.1mm_HandSoldering

Connections:
+5V: C22.1, C24.1, C25.1, C26.1, J5.2, J6.1, R27.2, U3.4 (VCC), U3.6 (VCC), U3.18 (AVCC), U4.2 (VO); also elsewhere on the board
+12V: C21.1, C23.1, U4.3 (VI); also elsewhere on the board
/24V 6 Cell Monitoring/ALERT: U3.32 (PD2); also elsewhere on the board
/24V 6 Cell Monitoring/SCL: U3.28 (PC5); also elsewhere on the board
/24V 6 Cell Monitoring/SDA: U3.27 (PC4); also elsewhere on the board
/24V 6 Cell Monitoring/VCOUT: U3.25 (PC2); also elsewhere on the board
/24V 6 Cell Monitoring/VIOUT: U3.26 (PC3); also elsewhere on the board
/24V 6 Cell Monitoring/VREF: U3.20 (AREF); also elsewhere on the board
/24V 6 Cell Monitoring/VTB: U3.24 (PC1); also elsewhere on the board
/MCU/MISO: J5.1, R28.1, U3.16 (PB4)
/MCU/MOSI: J5.4, U3.15 (PB3)
/MCU/RXD: J6.2, U3.30 (PD0)
/MCU/SCK: J5.3, U3.17 (PB5)
/MCU/SW: U3.13 (PB1); also elsewhere on the board
/MCU/TXD: J6.3, U3.31 (PD1)
/MCU/XTAL1: U3.7 (XTAL1/PB6), Y1.1
/MCU/XTAL2: U3.8 (XTAL2/PB7), Y1.2
/MCU/~RESET: C27.1, J5.5, R27.1, U3.29 (~RESET/PC6)
GND: C21.2, C22.2, C23.2, C24.2, C25.2, C26.2, C27.2, D7.1 (K), J5.6, J6.4, U3.3 (GND), U3.5 (GND), U3.21 (GND), U4.1 (GND), Y1.3; also elsewhere on the board
unnamed: D7.2 (A), R28.2

Notes on the sheet:
~{TVNBTEk=}
MCU - Resonator
MCU
MCU - UART
MCU - TEST LED
MCU - Programmer
MCU - RESET
12V to 5V LDO

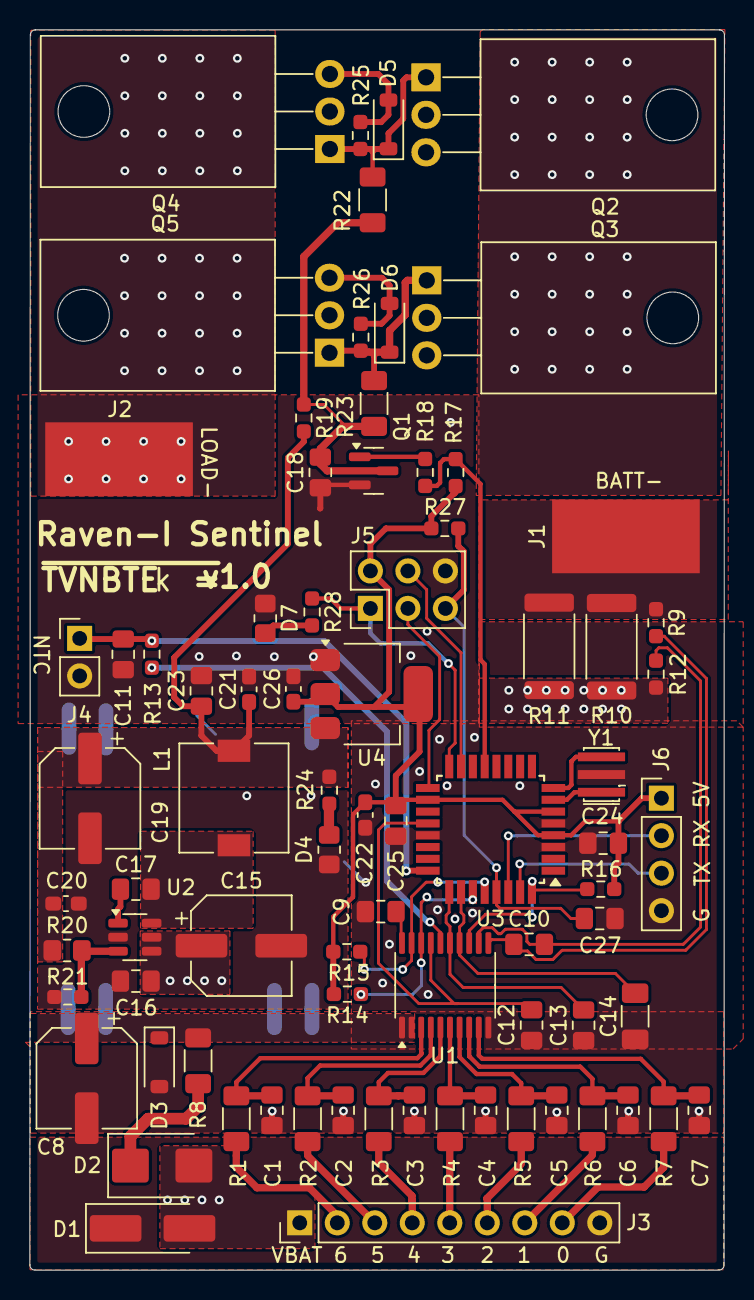
[picture p33: board BQ76925_ATMEGA328P_6S_20A_BMS.kicad_pcb from above]

Board: 2 copper layers, 47.0 x 84.0 mm, 79 parts (0 on the bottom side), 54 nets.
