M-S-Ali/raven-i-sentinel/firmware/bq76925_atmega328_24v_20a_bms/bq76925_atmega328_24v_20a_bms.ino

#include <Arduino_FreeRTOS.h>
#include <semphr.h>
#include <Wire.h>
#include "bq76925_driver.h"

LFP_Battery battery;

char json_buffer[35];

SemaphoreHandle_t xBqLibrarySemaphore;

void send_data_over_UART( void *pvParameters );
void read_and_update_cell_voltage( void *pvParameters );
void pack_param( void *pvParameters __attribute__((unused)) );

void setup() {
  Serial.begin(9600);
  Wire.begin();

  battery.init();
  
  if ( xBqLibrarySemaphore == NULL ) {
    xBqLibrarySemaphore = xSemaphoreCreateMutex();
    if ( ( xBqLibrarySemaphore ) != NULL )
      xSemaphoreGive( ( xBqLibrarySemaphore ) );
  }

  xTaskCreate(send_data_over_UART, "send_data_over_UART", 128, NULL, 1, NULL);
  xTaskCreate(read_and_update_cell_voltage, "CellVoltage", 128, NULL, 1, NULL);
}

void loop() {}

void send_data_over_UART( void *pvParameters __attribute__((unused)) ) {  
  for (;;){
    if(xSemaphoreTake(xBqLibrarySemaphore, portMAX_DELAY)){
      snprintf(json_buffer, sizeof(json_buffer),"{\"cv\":[%d,%d,%d,%d,%d,%d]}",
                              battery.cell_v[0],battery.cell_v[1],battery.cell_v[2],
                              battery.cell_v[3],battery.cell_v[4],battery.cell_v[5]);
      Serial.println(json_buffer);

      snprintf(json_buffer, sizeof(json_buffer),"{\"pv\":%d,\"pi\":%d,\"pt\":%d}",
                              battery.pack_v,battery.pack_i,battery.pack_temperature);
      Serial.println(json_buffer);

      snprintf(json_buffer, sizeof(json_buffer),"{\"cb\":[%d,%d,%d,%d,%d,%d]}",
                              battery.cell_bal[0],battery.cell_bal[1],battery.cell_bal[2],
                              battery.cell_bal[3],battery.cell_bal[4],battery.cell_bal[5]);
      Serial.println(json_buffer);
      xSemaphoreGive(xBqLibrarySemaphore);
    }

  vTaskDelay(pdMS_TO_TICKS(1000));
  }
}

void read_and_update_cell_voltage( void *pvParameters __attribute__((unused)) ) {
  for (;;){
    if(xSemaphoreTake(xBqLibrarySemaphore, portMAX_DELAY)){
      battery.update_cell_v();
      battery.update_pack_param();
      xSemaphoreGive(xBqLibrarySemaphore);
      vTaskDelay(5);
    }
  }
}

void cell_balancing(){
  // variable to store average and cell balancing register
  uint8_t cell_avg_v = 0;
  uint8_t cell_balancing_reg=0;
    
  //calculate the average
  for (uint8_t i=0; i<6; i++)
    cell_avg_v += battery.cell_v[i];
  cell_avg_v = cell_avg_v/6;
    
  // mark the cells eligible for balancing
  for (uint8_t i=0; i<6; i++){
    if (battery.cell_v[i]>360 && (battery.cell_v[i]-cell_avg_v > 20))
      cell_balancing_reg |= 1<<i;
  }
            
  // if two adjacent cells are marked for balancing remove mark for cell with lower voltage
  for (uint8_t i=0; i<6; i++){
    if (cell_balancing_reg>>i & 1){
      if (cell_balancing_reg>>i+1 & 1){
        if (battery.cell_v[i]>battery.cell_v[i+1])
          cell_balancing_reg &= ~(1<<(i+1));
        else
          cell_balancing_reg &= ~(1<<i); 
      }
    }
  }
  // update value cell_balancing_reg to bq76925
  // balancing delay to be implemented
}
