M-S-Ali/raven-i-sentinel/(commit log)

2024-11-20 created pcb kicad project and folder structure
    [BQ76925_ATMEGA328P_6S_20A_BMS.kicad_pcb, BQ76925_ATMEGA328P_6S_20A_BMS.kicad_sch]
2024-11-21 started with schematic included main components to library
    [BQ76925_ATMEGA328P_6S_20A_BMS.kicad_sch]
2024-11-22 schematic progress completed AFE, made schematic structure
    [Atmega328P.kicad_sch, BQ76925_ATMEGA328P_6S_20A_BMS.kicad_sch, BQ76925_Schematic.kicad_sch, IRFB4110_Power_Switch.kicad_sch]
2024-11-23 schematic completed component need to be finalised
    [Atmega328P.kicad_sch, BQ76925_ATMEGA328P_6S_20A_BMS.kicad_sch, BQ76925_Schematic.kicad_sch, IRFB4110_Power_Switch.kicad_sch]
2024-11-23 schematic symbol library updated
2024-11-23 Schematic completed components calculated need to check avaialability
    [Atmega328P.kicad_sch, BQ76925_ATMEGA328P_6S_20A_BMS.kicad_sch, BQ76925_Schematic.kicad_sch, IRFB4110_Power_Switch.kicad_sch]
2024-11-24 added power led and mcu test led in schematic
    [Atmega328P.kicad_sch, IRFB4110_Power_Switch.kicad_sch]
2024-11-25 common footprints assigned to symbols
    [Atmega328P.kicad_sch, BQ76925_Schematic.kicad_sch, IRFB4110_Power_Switch.kicad_sch]
2024-11-25 schematic components footprint updated
    [Atmega328P.kicad_sch, BQ76925_ATMEGA328P_6S_20A_BMS.kicad_sch, BQ76925_Schematic.kicad_sch, IRFB4110_Power_Switch.kicad_sch]
2024-11-26 MCU - Crystal replaced with resonator
    [Atmega328P.kicad_sch]
2024-11-26 schematic pdf updated. docs/datasheet updated sense resistor and transistor
2024-11-26 pcb design half complete
    [Atmega328P.kicad_sch, BQ76925_ATMEGA328P_6S_20A_BMS.kicad_pcb, BQ76925_ATMEGA328P_6S_20A_BMS.kicad_sch, BQ76925_Schematic.kicad_sch, IRFB4110_Power_Switch.kicad_sch]
2024-11-27 routing issue analog pins parallel routing and more length need to plan
    [BQ76925_ATMEGA328P_6S_20A_BMS.kicad_pcb, BQ76925_Schematic.kicad_sch]
2024-11-28 pcb placement and 90 percent routed
    [Atmega328P.kicad_sch, BQ76925_ATMEGA328P_6S_20A_BMS.kicad_pcb]
2024-11-29 PCB DRC complete footprints library exported. PCB optimization required
    [Atmega328P.kicad_sch, BQ76925_ATMEGA328P_6S_20A_BMS.kicad_pcb, BQ76925_ATMEGA328P_6S_20A_BMS.kicad_sch, BQ76925_Schematic.kicad_sch, IRFB4110_Power_Switch.kicad_sch]
2024-11-29 completed pcb layout DRC completed. Final review and sleep with design pending
    [BQ76925_ATMEGA328P_6S_20A_BMS-B_Cu.gbl, BQ76925_ATMEGA328P_6S_20A_BMS-B_Mask.gbs, BQ76925_ATMEGA328P_6S_20A_BMS-B_Silkscreen.gbo, BQ76925_ATMEGA328P_6S_20A_BMS-Edge_Cuts.gm1, BQ76925_ATMEGA328P_6S_20A_BMS-F_Cu.gtl, BQ76925_ATMEGA328P_6S_20A_BMS-F_Mask.gts, BQ76925_ATMEGA328P_6S_20A_BMS-F_Silkscreen.gto, BQ76925_ATMEGA328P_6S_20A_BMS-NPTH.drl]
2024-12-04 3d library made independent
    [Atmega328P.kicad_sch, BQ76925_ATMEGA328P_6S_20A_BMS.kicad_pcb, CP_Elec_6.3x5.7.step, C_0603_1608Metric.step, C_0805_2012Metric.step, C_1206_3216Metric.step, D_SMA.step, D_SMB.step]
2025-01-31 PCB design ver 1.0 archived
2025-07-05 saved pcb as new kicad version
    [Atmega328P.kicad_sch, BQ76925_ATMEGA328P_6S_20A_BMS.kicad_sch, BQ76925_Schematic.kicad_sch, IRFB4110_Power_Switch.kicad_sch]
2025-07-06 basic working firmware with rtos added
    need to add cell bal code, test i2c, document
2025-07-20 driver development and calibration in progress
2025-07-20 vcn calibration applied
